yury-g/nearby-buddy/docs/images/nearby-buddy-devices.png

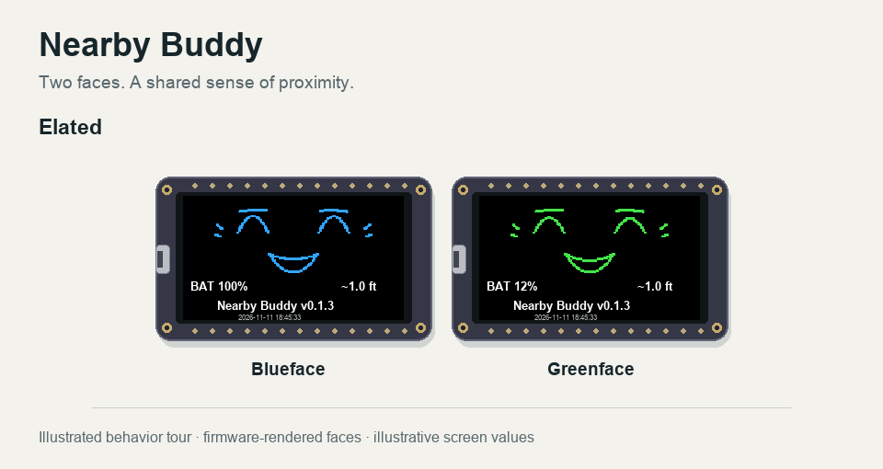
docs/images/nearby-buddy-devices.png
