yury-g/nearby-buddy/enclosure/textures/screen-blue.png

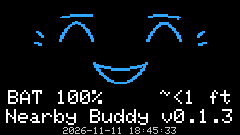
enclosure/textures/screen-blue.png
