yury-g/nearby-buddy/enclosure/stl/lid_assembly.stl

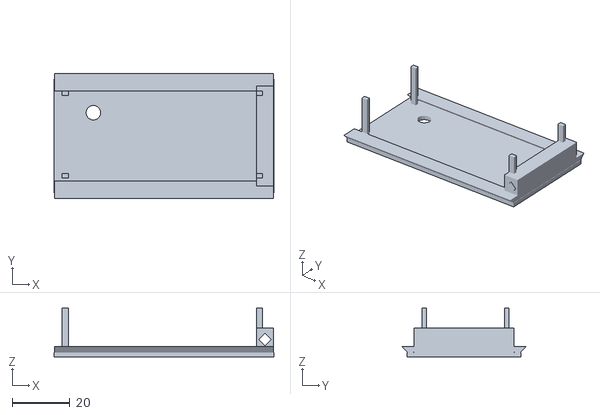
[picture p17: CAD file, 2026-11-12]
enclosure/stl/lid_assembly.stl
75.9 x 43.0 x 16.9
