yury-g/nearby-buddy/enclosure/stl/carrier_assembly.stl

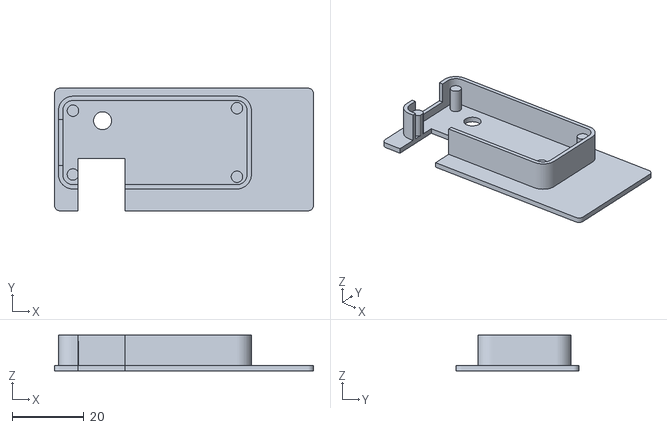
[picture p18: CAD file, 2026-11-12]
enclosure/stl/carrier_assembly.stl
72.2 x 34.2 x 9.90
