yury-g/nearby-buddy/enclosure/stl/shell_assembly.stl

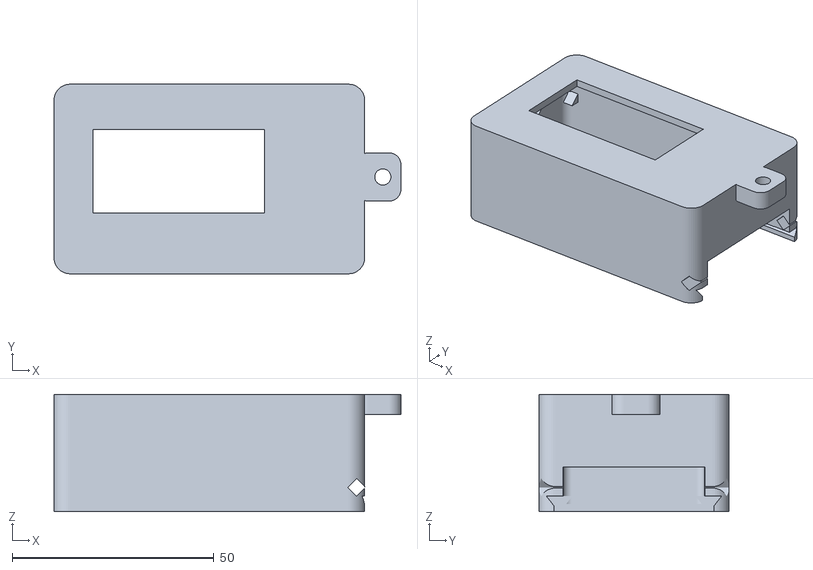
[picture p19: CAD file, 2026-11-12]
enclosure/stl/shell_assembly.stl
86.0 x 47.0 x 29.0
