yury-g/nearby-buddy/enclosure/stl/key_assembly.stl

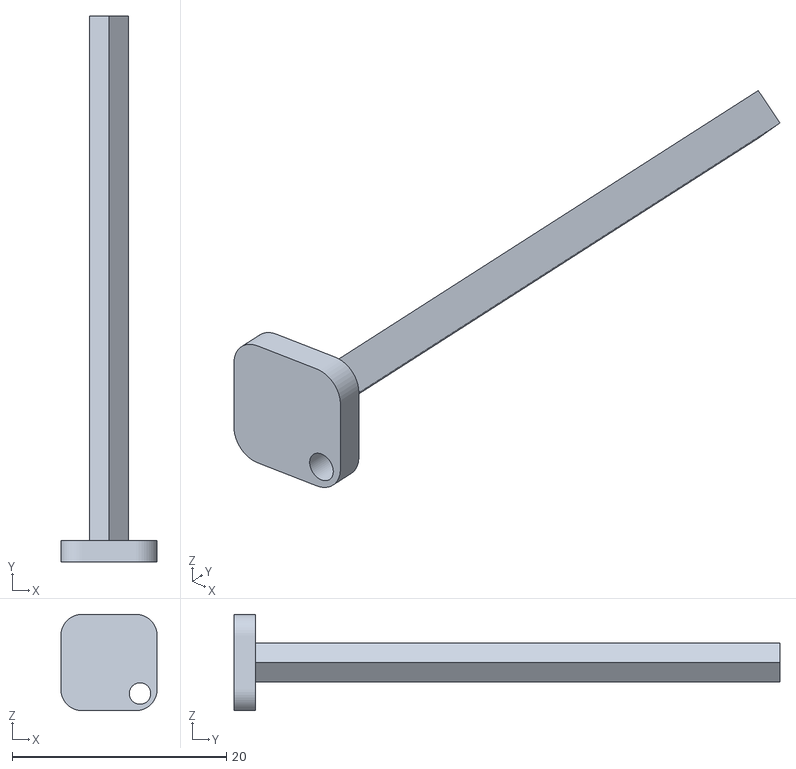
[picture p20: CAD file, 2026-11-12]
enclosure/stl/key_assembly.stl
9.00 x 51.0 x 9.00
