yury-g/nearby-buddy/enclosure/reference/board.stl

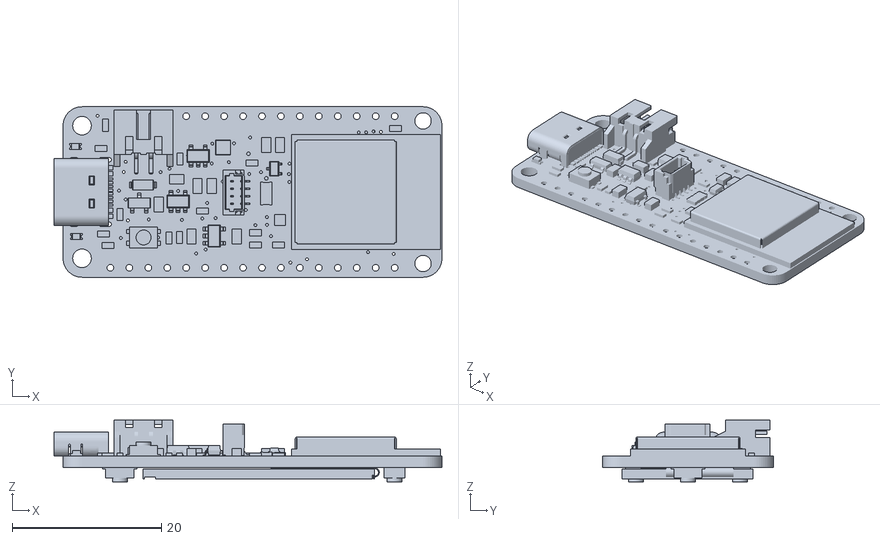
[picture p21: CAD file, 2026-11-12]
enclosure/reference/board.stl
52.0 x 22.9 x 8.27
