yury-g/nearby-buddy/enclosure/stl/larger-battery.stl

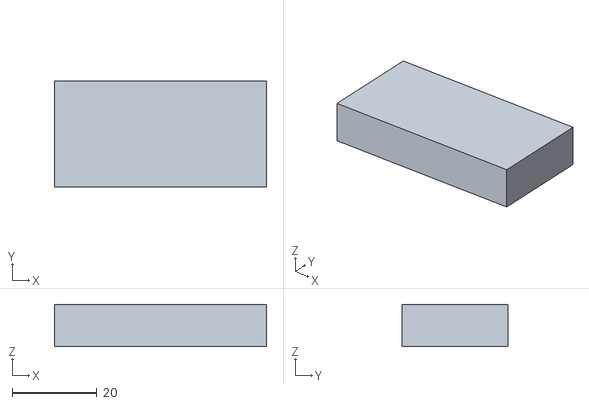
[picture p22: CAD file, 2026-11-12]
enclosure/stl/larger-battery.stl
50.0 x 25.0 x 10.0
