yury-g/nearby-buddy/enclosure/stl/wires.stl

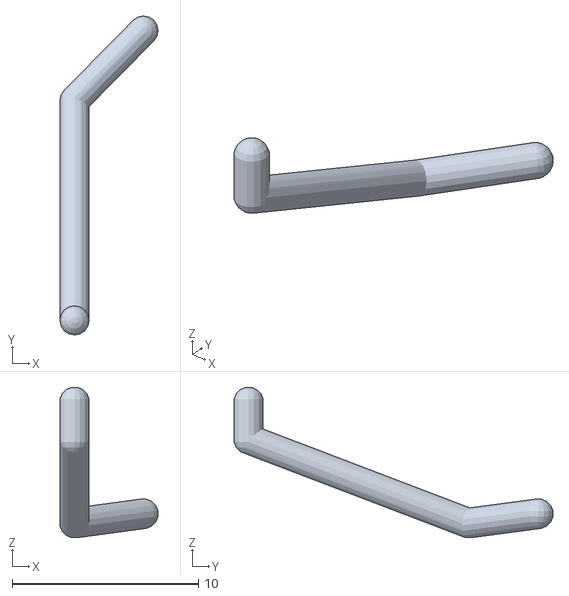
[picture p23: CAD file, 2026-11-12]
enclosure/stl/wires.stl
5.27 x 17.1 x 8.07
