yury-g/nearby-buddy/enclosure/stl/bay.stl

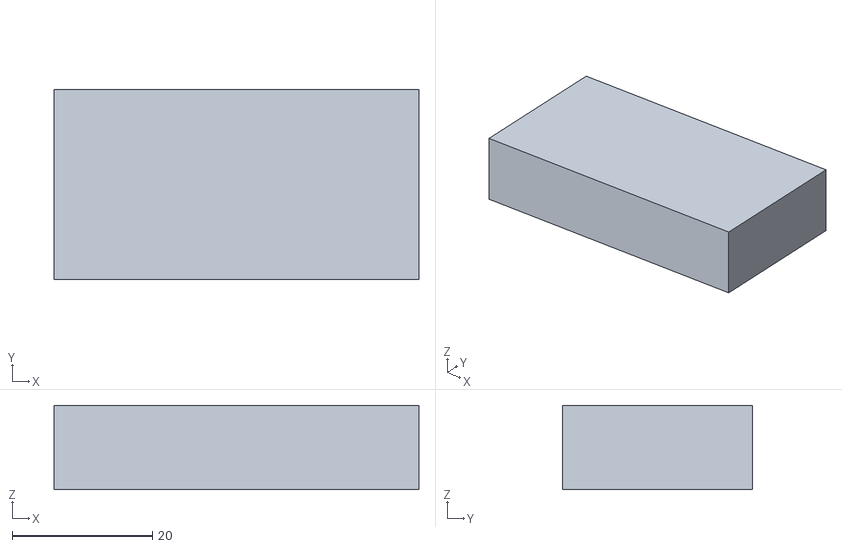
[picture p24: CAD file, 2026-11-12]
enclosure/stl/bay.stl
52.0 x 27.0 x 12.0
