yury-g/nearby-buddy/enclosure/stl/plug.stl

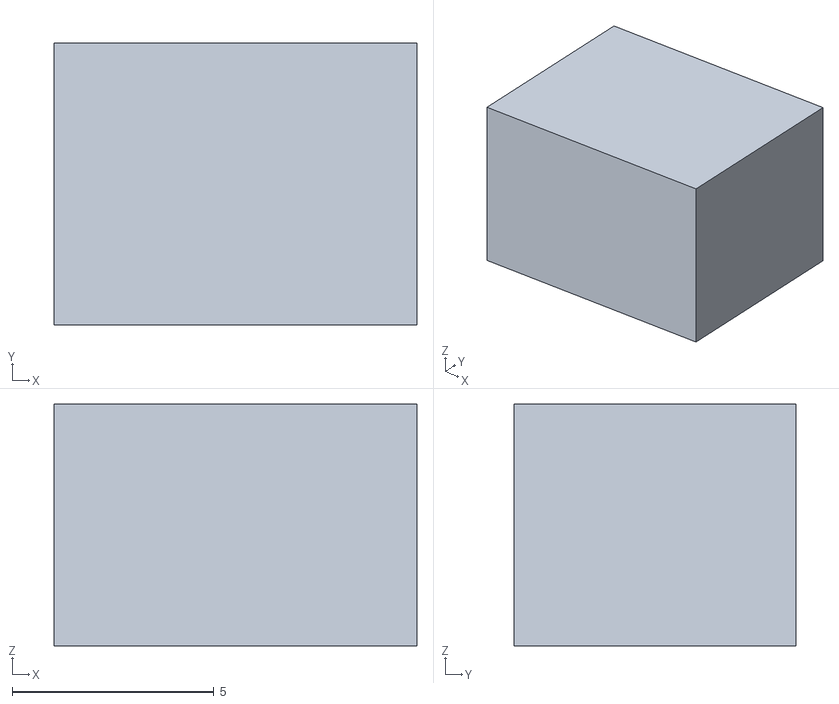
[picture p25: CAD file, 2026-11-12]
enclosure/stl/plug.stl
9.00 x 7.00 x 6.00
