yury-g/nearby-buddy/enclosure/stl/joint-coupon.stl

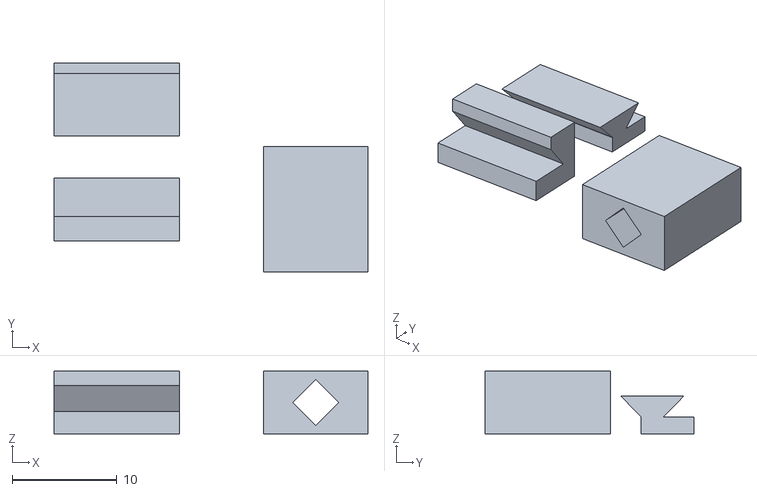
[picture p26: CAD file, 2026-11-12]
enclosure/stl/joint-coupon.stl
30.0 x 20.0 x 6.00
