yury-g/nearby-buddy/enclosure/stl/battery.stl

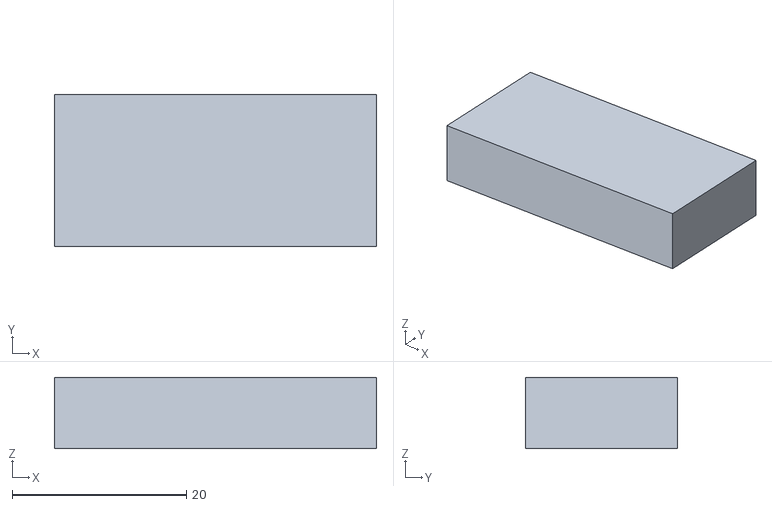
[picture p27: CAD file, 2026-11-12]
enclosure/stl/battery.stl
37.0 x 17.5 x 8.20
