yury-g/nearby-buddy/(list of files, cad)

Other CAD files:
enclosure/stl/carrier.stl
enclosure/stl/board.stl
enclosure/stl/key.stl
enclosure/stl/shell.stl
enclosure/studio/nearby-buddy.blend
