yury-g/nearby-buddy/(commit log)

2026-11-12 Publish Nearby Buddy lab handoff, prototype roadmap and printable enclosure
    Preserve the v0.1.3 firmware checkpoint with visual behavior tour and student AI prompts. Add vendor-dimensioned CAD, larger battery bay, keyed support-free print parts, fit checks, isometric renders and an offline 3D viewer. Physical enclosure fit remains untested.
    [battery.stl, bay.stl, board.stl, carrier.stl, carrier_assembly.stl, joint-coupon.stl, key.stl, key_assembly.stl]
2026-11-12 Add linked parts list and CAD studio renders with native firmware screens
    Stage vendor Feather geometry in Blender, embed Blueface and Greenface screens in the offline viewer, and document reproducible rendering and battery envelope limitations.
    [nearby-buddy.blend]
